erdemts/IO_55_/Dosyalar/cihaz resim.jpg

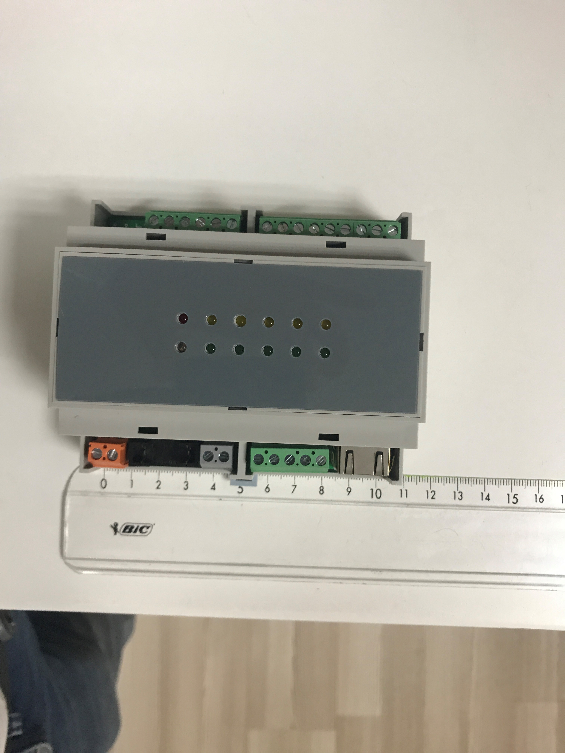
Dosyalar/cihaz resim.jpg
