erdemts/IO_55_/Dosyalar/Bullwark.jpg

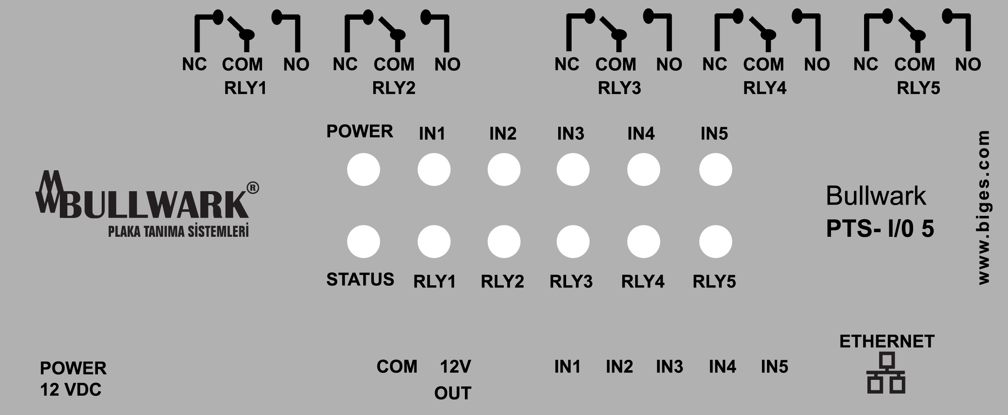
Dosyalar/Bullwark.jpg
