erdemts/IO_55_/Dosyalar/INNO_leksan_IO.PNG

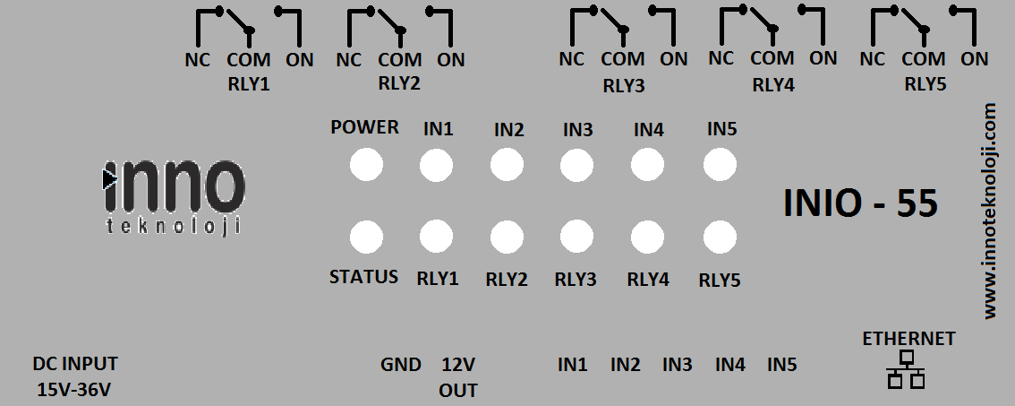
Dosyalar/INNO_leksan_IO.PNG
