erdemts/IO_55_/Dosyalar/Kutu.JPG

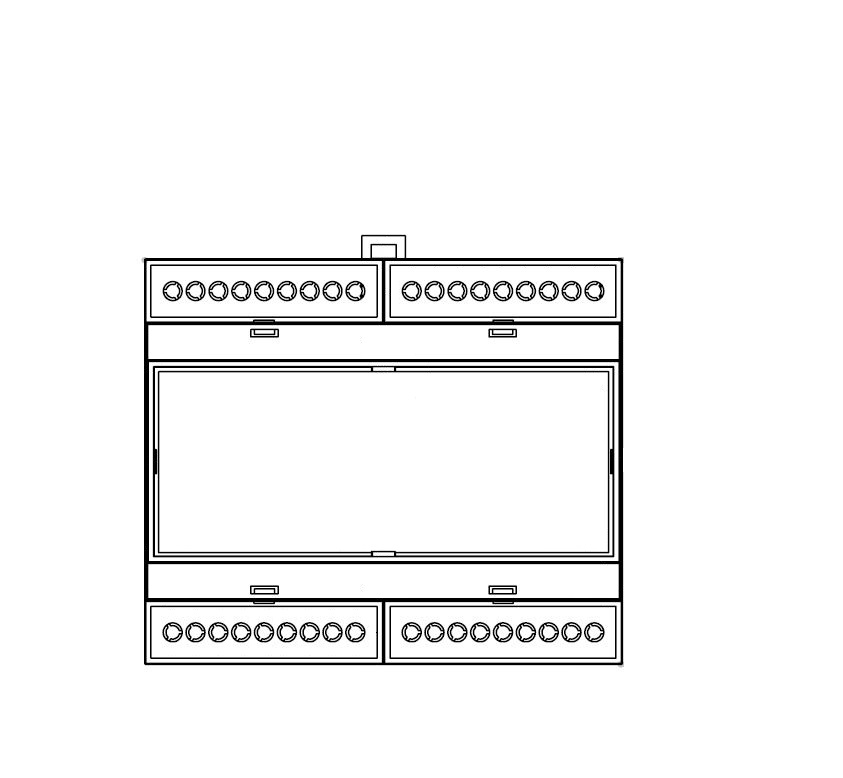
Dosyalar/Kutu.JPG
