erdemts/IO_55_/Dosyalar/leksan_IO_.PNG

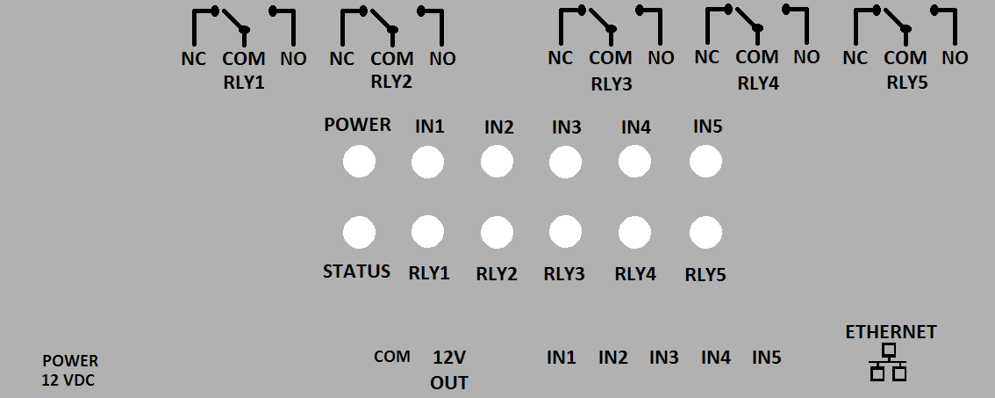
Dosyalar/leksan_IO_.PNG
