erdemts/IO_55_/Dosyalar/IO_Module.xlsx

Sheet: IO_Module (2)
Qty | Value | Device | Package | Parts
2 |  | FE10-2 | FE10-2 | SV1, SV2 | 0.3 | 0.6
1 |  | PINHD-1X5 | 1X05 | ICSP | 0.02 | 0.02
7 | 0R | R-EU_M0805 | M0805 | R7, R15, R16, R17, R18, R19, R20 | 0.0008 | 0.0056
5 | 100nF | C-EUC0603 | C0603 | C4, C6, C8, C10, C41 | 0.0022 | 0.011
3 | 100nF | C-EUC0603K | C0603K | C1, C2, C3 | 0.0022 | 0.0066
1 | 100uF | CPOL-EU153CLV-0605 | 153CLV-0605 | C55 | 0.11 | 0.11
1 | 100uF 50V | CPOL-EU153CLV-0810 | 153CLV-0810 | C9, C30 | 0.1 | 0.1
5 | 10K | R-EU_M0805 | M0805 | R4, R53, R55, R57, R59 | 0.0008 | 0.004
3 | 10K | R-EU_R0805 | R0805 | R3, R6, R11 | 0.0008 | 0.0024
1 | 10uF | CPOL-EU153CLV-0505 | 153CLV-0505 | C5 | 0.05 | 0.05
5 | 1K | R-EU_M0805 | M0805 | R5, R54, R56, R58, R60 | 0.0008 | 0.004
6 | 1N4148 | GF1 | SMA-DO214AC | D1, D2, D3, D4, D5, D6 | 0.006 | 0.036
1 | 2k | R-EU_M0805 | M0805 | R111 | 0.0008 | 0.0008
2 | 3k3 | R-EU_R0805 | R0805 | R79, R80 | 0.0008 | 0.0016
1 | 4.7uF 25V | CPOL-USA/3216-18R | A/3216-18R | C7 | 0.05 | 0.05
1 | 470R | R-EU_R0805 | R0805 | R2 | 0.0008 | 0.0008
2 | 47k | R-EU_R0805 | R0805 | R81, R82 | 0.0008 | 0.0016
7 | 620R | R-EU_R0805 | R0805 | R1, R8, R9, R10, R12, R13, R14 | 0.0008 | 0.0056
2 | BC817-16LT1SMD | BC817-16LT1SMD | SOT23-BEC | Q8, Q9 | 0.0095 | 0.019
1 | DIODEBRIDGE | DIODEBRIDGE | SDIP | DB1 | 0.1 | 0.1
5 | JW1FSN-DC12V | G5Q-1-12V | G5Q-1-12V | RLY1, RLY2, RLY3, RLY4, RLY5 | 0.41 | 2.05
1 | L7805CD2T-TR | VREG-7805-DPAK2 | VREG-7805-DPAK2 | U$6 | 0.25 | 0.25
2 | LD117AS12TR | LD117AS12TR | SOT223 | IC3, IC4 | 0.12 | 0.24
2 | MKDSN1,5/2-5,08 | MKDSN1,5/2-5,08 | MKDSN1,5/2-5,08 | X2, X9 | 0.1 | 0.2
5 | MKDSN1,5/3-5,08 | MKDSN1,5/3-5,08 | MKDSN1,5/3-5,08 | X4, X5, X6, X7, X8 | 0.135 | 0.675 | 10.53
1 | MKDSN1,5/5-5,08 | MKDSN1,5/5-5,08 | MKDSN1,5/5-5,08 | X1 | 0.22 | 0.22
1 | PIC16F887PT | PIC16F877PT | TQFP44 | IC1 | 1.5 | 1.5
1 | PILOT_FUSEHOLD |  |  | FUSE | 0.15 | 0.15
12 | TLLR4400 | TLLR4400 | LED3MM | LED1, LED3, LED4, LED5, LED6, LED7, LED8, LED9, LED10, LED11, LED12, LED13 | 0.02 | 0.24
5 | TLP283 | TLP283 | MINI-FLAT-4 | OK1, OK2, OK3, OK4, OK8 | 0.25 | 1.25
1 | ULN2003AD | ULN2003AD | SO16 | IC7 | 0.14 | 0.14
1 | USR-K2 | USR-K2 | USR-K2 | ETH2 | 11.33 | 11.33
1 | fuse |  |  |  | 0.1 | 0.1
1 | pcb |  |  |  | 2.5 | 2.5
1 | kutu |  |  |  | 6.4 | 6.4
1 | dizgi |  |  |  | 3.5 | 3.5
1 | membran |  |  |  | 0.8 | 0.8
 |  |  |  |  |  | 32.674 | 42.4762 | 29.254 | 13.2222 | 396.666
 |  |  |  |  |  |  |  |  |  | 407.196
 |  |  |  |  |  |  |  |  |  | 84.9524
 |  |  |  |  |  |  |  |  |  | 492.1484
 |  |  |  |  |  |  |  |  |  | 500

Sheet: IO_Module
Qty | Value | Device | Package | Parts
1 |  | CRYSTALHC49UP | HC49UP | Q3 | 0 | 0
2 |  | FE10-2 | FE10-2 | SV1, SV2 | 0.3 | 0.6
0 |  | LEDCHIPLED_0805 | CHIPLED_0805 | LED2 | 0 | 0
1 |  | PINHD-1X5 | 1X05 | ICSP | 0.02 | 0.02
7 | 0R | R-EU_M0805 | M0805 | R7, R15, R16, R17, R18, R19, R20 | 0.0008 | 0.0056
5 | 100nF | C-EUC0603 | C0603 | C4, C6, C8, C10, C41 | 0.0022 | 0.011
3 | 100nF | C-EUC0603K | C0603K | C1, C2, C3 | 0.0022 | 0.0066
1 | 100uF | CPOL-EU153CLV-0605 | 153CLV-0605 | C55 | 0.11 | 0.11
1 | 100uF 50V | CPOL-EU153CLV-0810 | 153CLV-0810 | C9, C30 | 0.1 | 0.1
5 | 10K | R-EU_M0805 | M0805 | R4, R53, R55, R57, R59 | 0.0008 | 0.004
3 | 10K | R-EU_R0805 | R0805 | R3, R6, R11 | 0.0008 | 0.0024
1 | 10uF | CPOL-EU153CLV-0505 | 153CLV-0505 | C5 | 0.05 | 0.05
0 | 14k | R-EU_M0805 | M0805 | R68 | 0.0008 | 0
5 | 1K | R-EU_M0805 | M0805 | R5, R54, R56, R58, R60 | 0.0008 | 0.004
6 | 1N4148 | GF1 | SMA-DO214AC | D1, D2, D3, D4, D5, D6 | 0.006 | 0.036
0 | 220uH | DR125 | DR125 | L5 | 0.15 | 0
0 | 22pF | C-EUC0805 | C0805 | C31, C32 | 0.0022 | 0
1 | 2k | R-EU_M0805 | M0805 | R111 | 0.0008 | 0.0008
2 | 3k3 | R-EU_R0805 | R0805 | R79, R80 | 0.0008 | 0.0016
1 | 4.7uF 25V | CPOL-USA/3216-18R | A/3216-18R | C7 | 0.05 | 0.05
1 | 470R | R-EU_R0805 | R0805 | R2 | 0.0008 | 0.0008
2 | 47k | R-EU_R0805 | R0805 | R81, R82 | 0.0008 | 0.0016
7 | 620R | R-EU_R0805 | R0805 | R1, R8, R9, R10, R12, R13, R14 | 0.0008 | 0.0056
0 | B540C_DIODE | B540C_DIODE | SMC | U$13 | 0.085 | 0
2 | BC817-16LT1SMD | BC817-16LT1SMD | SOT23-BEC | Q8, Q9 | 0.0095 | 0.019
1 | DIODEBRIDGE | DIODEBRIDGE | SDIP | DB1 | 0.1 | 0.1
5 | JW1FSN-DC12V | G5Q-1-12V | G5Q-1-12V | RLY1, RLY2, RLY3, RLY4, RLY5 | 0.41 | 2.05
1 | L7805CD2T-TR | VREG-7805-DPAK2 | VREG-7805-DPAK2 | U$6 | 0.25 | 0.25
2 | LD117AS12TR | LD117AS12TR | SOT223 | IC3, IC4 | 0.12 | 0.24
0 | LM2596S | LM2596S | TO263-5 | IC2 | 1 | 0
2 | MKDSN1,5/2-5,08 | MKDSN1,5/2-5,08 | MKDSN1,5/2-5,08 | X2, X9 | 0.1 | 0.2
5 | MKDSN1,5/3-5,08 | MKDSN1,5/3-5,08 | MKDSN1,5/3-5,08 | X4, X5, X6, X7, X8 | 0.135 | 0.675 | 10.53
1 | MKDSN1,5/5-5,08 | MKDSN1,5/5-5,08 | MKDSN1,5/5-5,08 | X1 | 0.22 | 0.22
0 | MOV-10D201K | MOV-10D201K | MOV-10D201K | MOV | 0.12 | 0
1 | PIC16F887PT | PIC16F877PT | TQFP44 | IC1 | 1.5 | 1.5
1 | PILOT_FUSEHOLD |  |  | FUSE | 0.15 | 0.15
12 | TLLR4400 | TLLR4400 | LED3MM | LED1, LED3, LED4, LED5, LED6, LED7, LED8, LED9, LED10, LED11, LED12, LED13 | 0.02 | 0.24
5 | TLP283 | TLP283 | MINI-FLAT-4 | OK1, OK2, OK3, OK4, OK8 | 0.25 | 1.25
1 | ULN2003AD | ULN2003AD | SO16 | IC7 | 0.14 | 0.14
1 | USR-K2 | USR-K2 | USR-K2 | ETH2 | 11.33 | 11.33
1 | fuse |  |  |  | 0.1 | 0.1
1 | elek |  |  |  | 1.25 | 1.25
1 | pcb |  |  |  | 2.5 | 2.5
1 | kutu |  |  |  | 6.4 | 6.4
1 | işçilik |  |  |  | 1.5 | 1.5
1 | dizgi |  |  |  | 3.5 | 3.5
1 | membran |  |  |  | 0.8 | 0.8
 |  |  |  |  |  | 35.424
