erdemts/IO_55_/(list of files, cad)

Other CAD files:
Software/ETH_IO5.X/dist/DEBUG/production/ETH_IO5.X.production.obj
Software/ETH_IO5.X/dist/Release/production/ETH_IO5.X.production.obj
