erdemts/IO_55_/Hardware/IO_Module_Project/IO_Module/IO_Module.brd

## EAGLE design Hardware/IO_Module_Project/IO_Module/IO_Module.brd (2018-05-25)

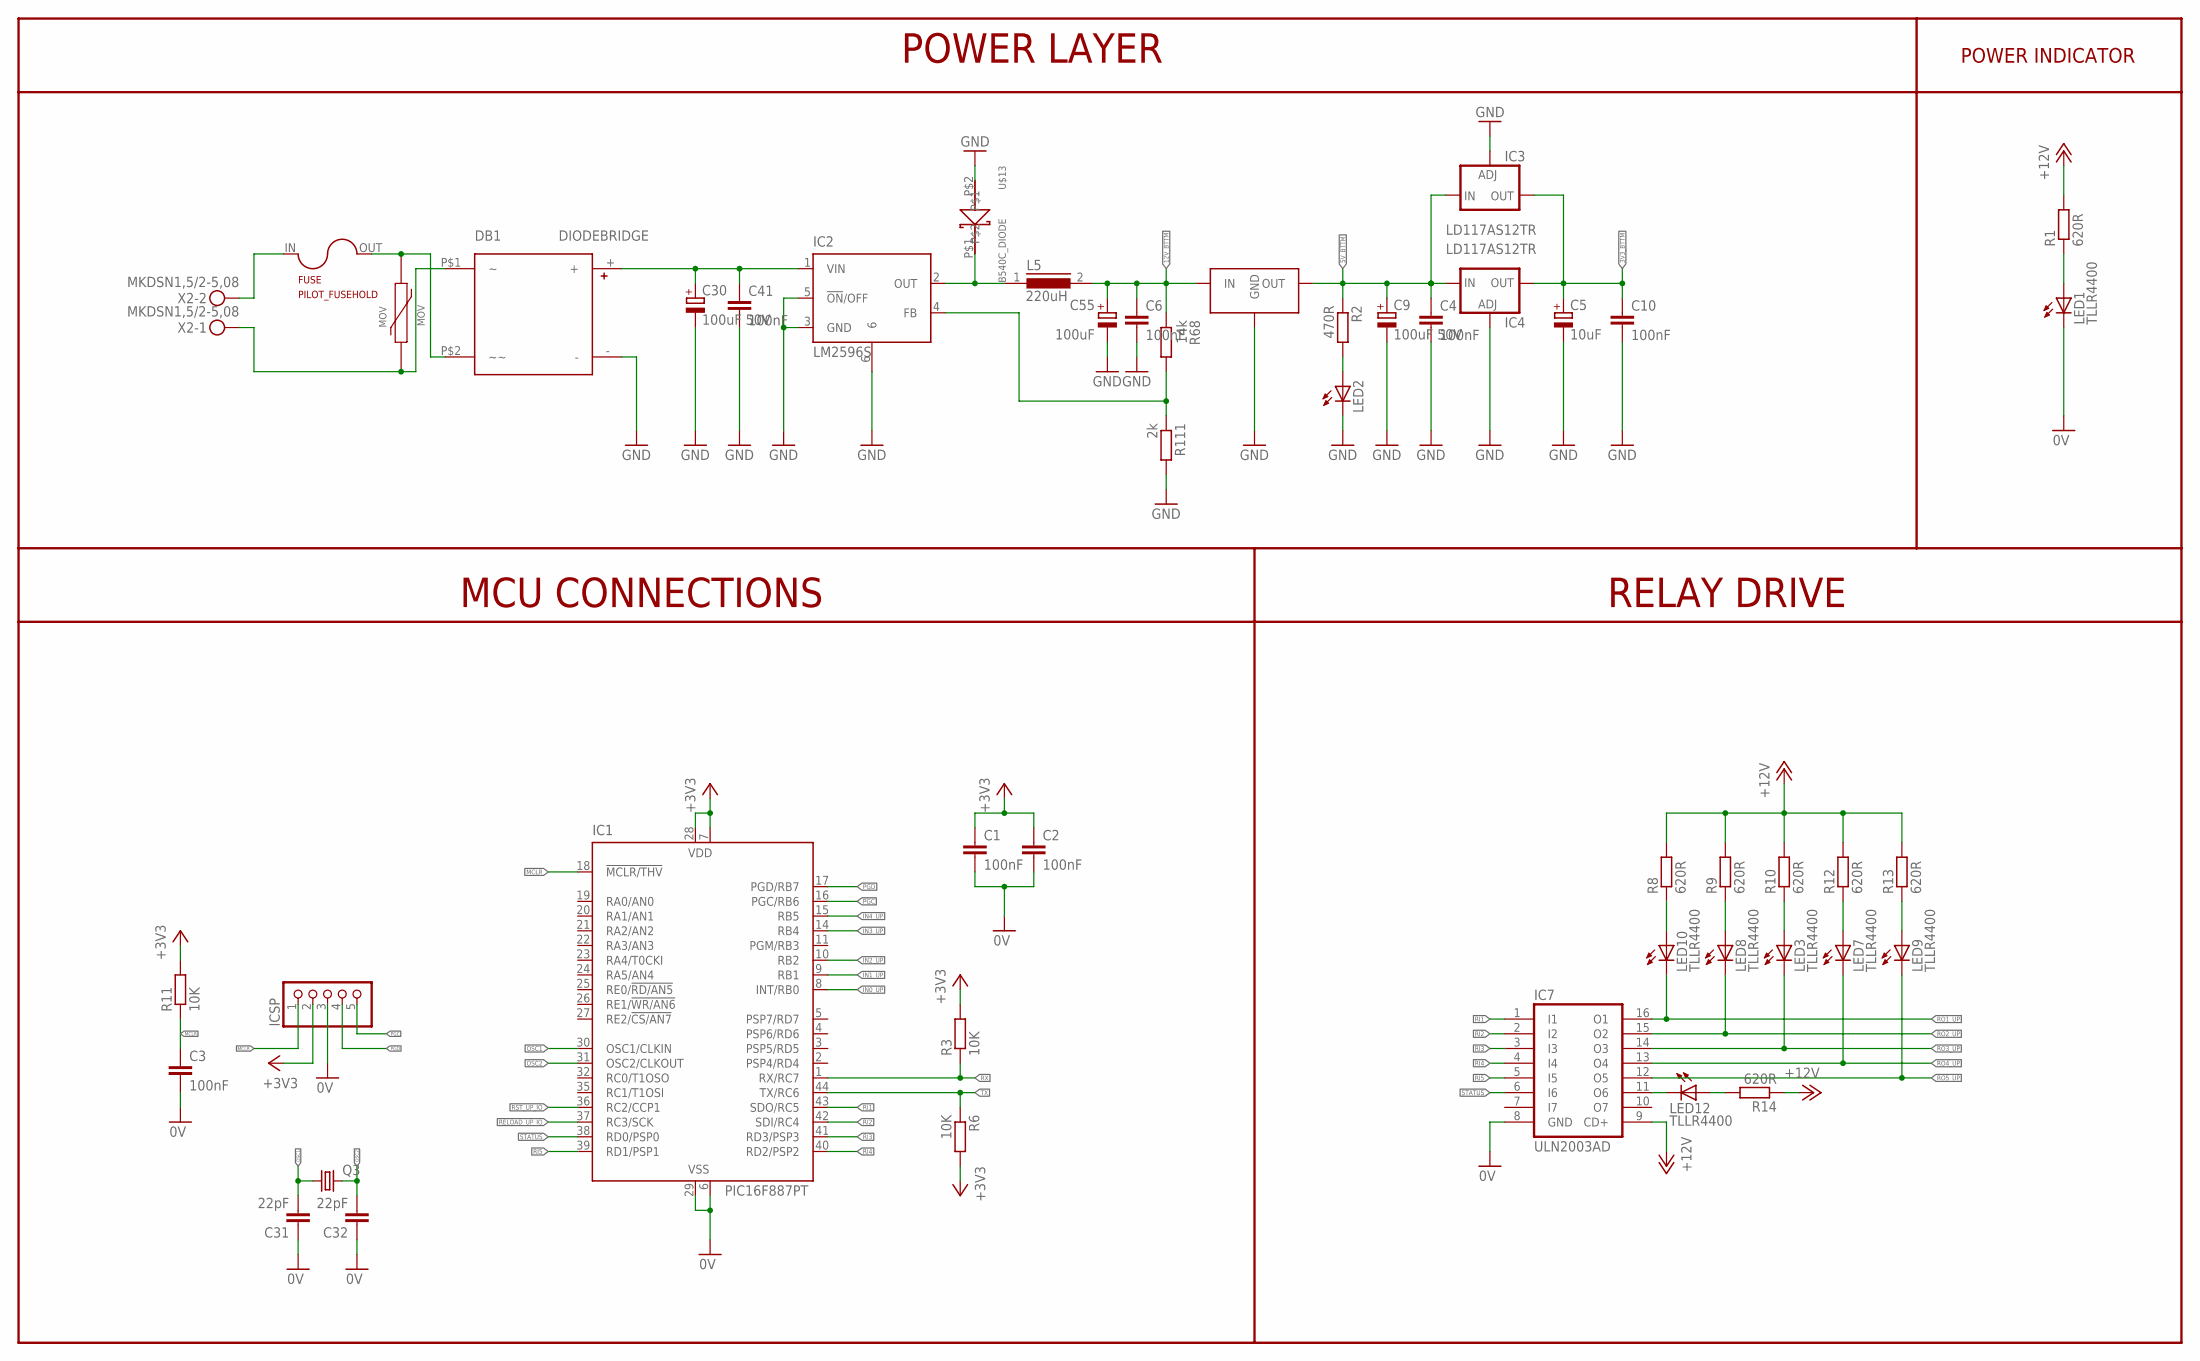
[picture p7: schematic IO_Module.sch, sheet 1]

Parts:
C1, C2, C3: 100nF; C0603K
C4, C6, C10, C41: 100nF; C0603
C5: 10uF; 153CLV-0505
C9, C30: 100uF 50V; 153CLV-0810
C31, C32: 22pF; C0805
C55: 100uF; 153CLV-0605
DB1: DIODEBRIDGE; SDIP
FUSE: PILOT_FUSEHOLD; RTM_FUSEHOLD
IC1: PIC16F887PT; TQFP44
IC2: LM2596S; TO263-5
IC3, IC4: LD117AS12TR; SOT223
IC7: ULN2003AD; SO16
ICSP: PINHD-1X5; 1X05
L5: 220uH; DR125
LED1, LED3, LED7, LED8, LED9, LED10, LED12: TLLR4400; LED3MM
LED2: LEDCHIPLED_0805; CHIPLED_0805
MOV: MOV-10D201K
Q3: CRYSTALHC49UP; HC49UP
R1, R8, R9, R10, R12, R13, R14: 620R; R0805
R2: 470R; R0805
R3, R6, R11: 10K; R0805
R68: 14k; M0805
R111: 2k; M0805
U$6: L7805CD2T-TR; VREG-7805-DPAK2
U$13: B540C_DIODE; SMC
X2: MKDSN1,5/2-5,08

Connections:
0V: C1.2, C2.2, C3.2, C31.1, C32.1, IC1.6 (VSS), IC1.29 (VSS), IC7.8 (GND), ICSP.3, LED1.K (C); also elsewhere on the board
3V3_BTTM: C5.+, C10.1, IC3.4 (OUT), IC4.4 (OUT); also elsewhere on the board
5V_BTTM: C4.1, C9.+, IC3.3 (IN), IC4.3 (IN), R2.1, U$6.VOUT (OUT)
12V_BTTM: C6.1, C55.+, L5.2, R68.1, U$6.VIN (IN); also elsewhere on the board
36V: C30.+, C41.1, DB1.+, IC2.1 (VIN)
+3V3: C1.1, C2.1, IC1.7 (VDD), IC1.28 (VDD), ICSP.2, R3.2, R6.2, R11.2; also elsewhere on the board
+12V: IC7.9 (CD+), R1.2, R8.2, R9.2, R10.2, R12.2, R13.2, R14.1; also elsewhere on the board
GND: C4.2, C5.-, C6.2, C9.-, C10.2, C30.-, C41.2, C55.-, DB1.-, IC2.3 (GND), IC2.5 (!ON!/OFF), IC2.6, IC3.1 (ADJ), IC4.1 (ADJ), LED2.C, R111.2, U$6.GND, U$13.P$2; also elsewhere on the board
IN0_UP: IC1.8 (INT/RB0); also elsewhere on the board
IN1_UP: IC1.9 (RB1); also elsewhere on the board
IN2_UP: IC1.10 (RB2); also elsewhere on the board
IN3_UP: IC1.14 (RB4); also elsewhere on the board
IN4_UP: IC1.15 (RB5); also elsewhere on the board
MCLR: C3.1, IC1.18 (!MCLR/THV), ICSP.1, R11.1
unnamed: LED2.A, R2.2
unnamed: DB1.P$2 (~~), FUSE.OUT, MOV.2
unnamed: DB1.P$1, MOV.1, X2.1
unnamed: FUSE.IN, X2.2
unnamed: LED1.A, R1.1
unnamed: IC7.11 (O6), LED12.K (C)
unnamed: LED10.A, R8.1
unnamed: LED8.A, R9.1
unnamed: LED3.A, R10.1
unnamed: LED7.A, R12.1
unnamed: LED9.A, R13.1
unnamed: LED12.A, R14.2
unnamed: IC2.2 (OUT), L5.1, U$13.P$1
unnamed: IC2.4 (FB), R68.2, R111.1
OSC1: C31.2, IC1.30 (OSC1/CLKIN), Q3.1
OSC2: C32.2, IC1.31 (OSC2/CLKOUT), Q3.2
PGC: IC1.16 (PGC/RB6), ICSP.5
PGD: IC1.17 (PGD/RB7), ICSP.4
RELOAD_UP_IO: IC1.37 (RC3/SCK); also elsewhere on the board
RI1: IC1.43 (SDO/RC5), IC7.1 (I1)
RI2: IC1.42 (SDI/RC4), IC7.2 (I2)
RI3: IC1.41 (RD3/PSP3), IC7.3 (I3)
RI4: IC1.40 (RD2/PSP2), IC7.4 (I4)
RI5: IC1.39 (RD1/PSP1), IC7.5 (I5)
RO1_UP: IC7.16 (O1), LED10.K (C); also elsewhere on the board
RO2_UP: IC7.15 (O2), LED8.K (C); also elsewhere on the board
RO3_UP: IC7.14 (O3), LED3.K (C); also elsewhere on the board
RO4_UP: IC7.13 (O4), LED7.K (C); also elsewhere on the board
RO5_UP: IC7.12 (O5), LED9.K (C); also elsewhere on the board
RST_UP_IO: IC1.36 (RC2/CCP1); also elsewhere on the board
RX: IC1.1 (RX/RC7), R3.1; also elsewhere on the board
STATUS: IC1.38 (RD0/PSP0), IC7.6 (I6)
TX: IC1.44 (TX/RC6), R6.1; also elsewhere on the board

Notes on the sheet:
POWER LAYER
MCU CONNECTIONS
RELAY DRIVE
POWER INDICATOR

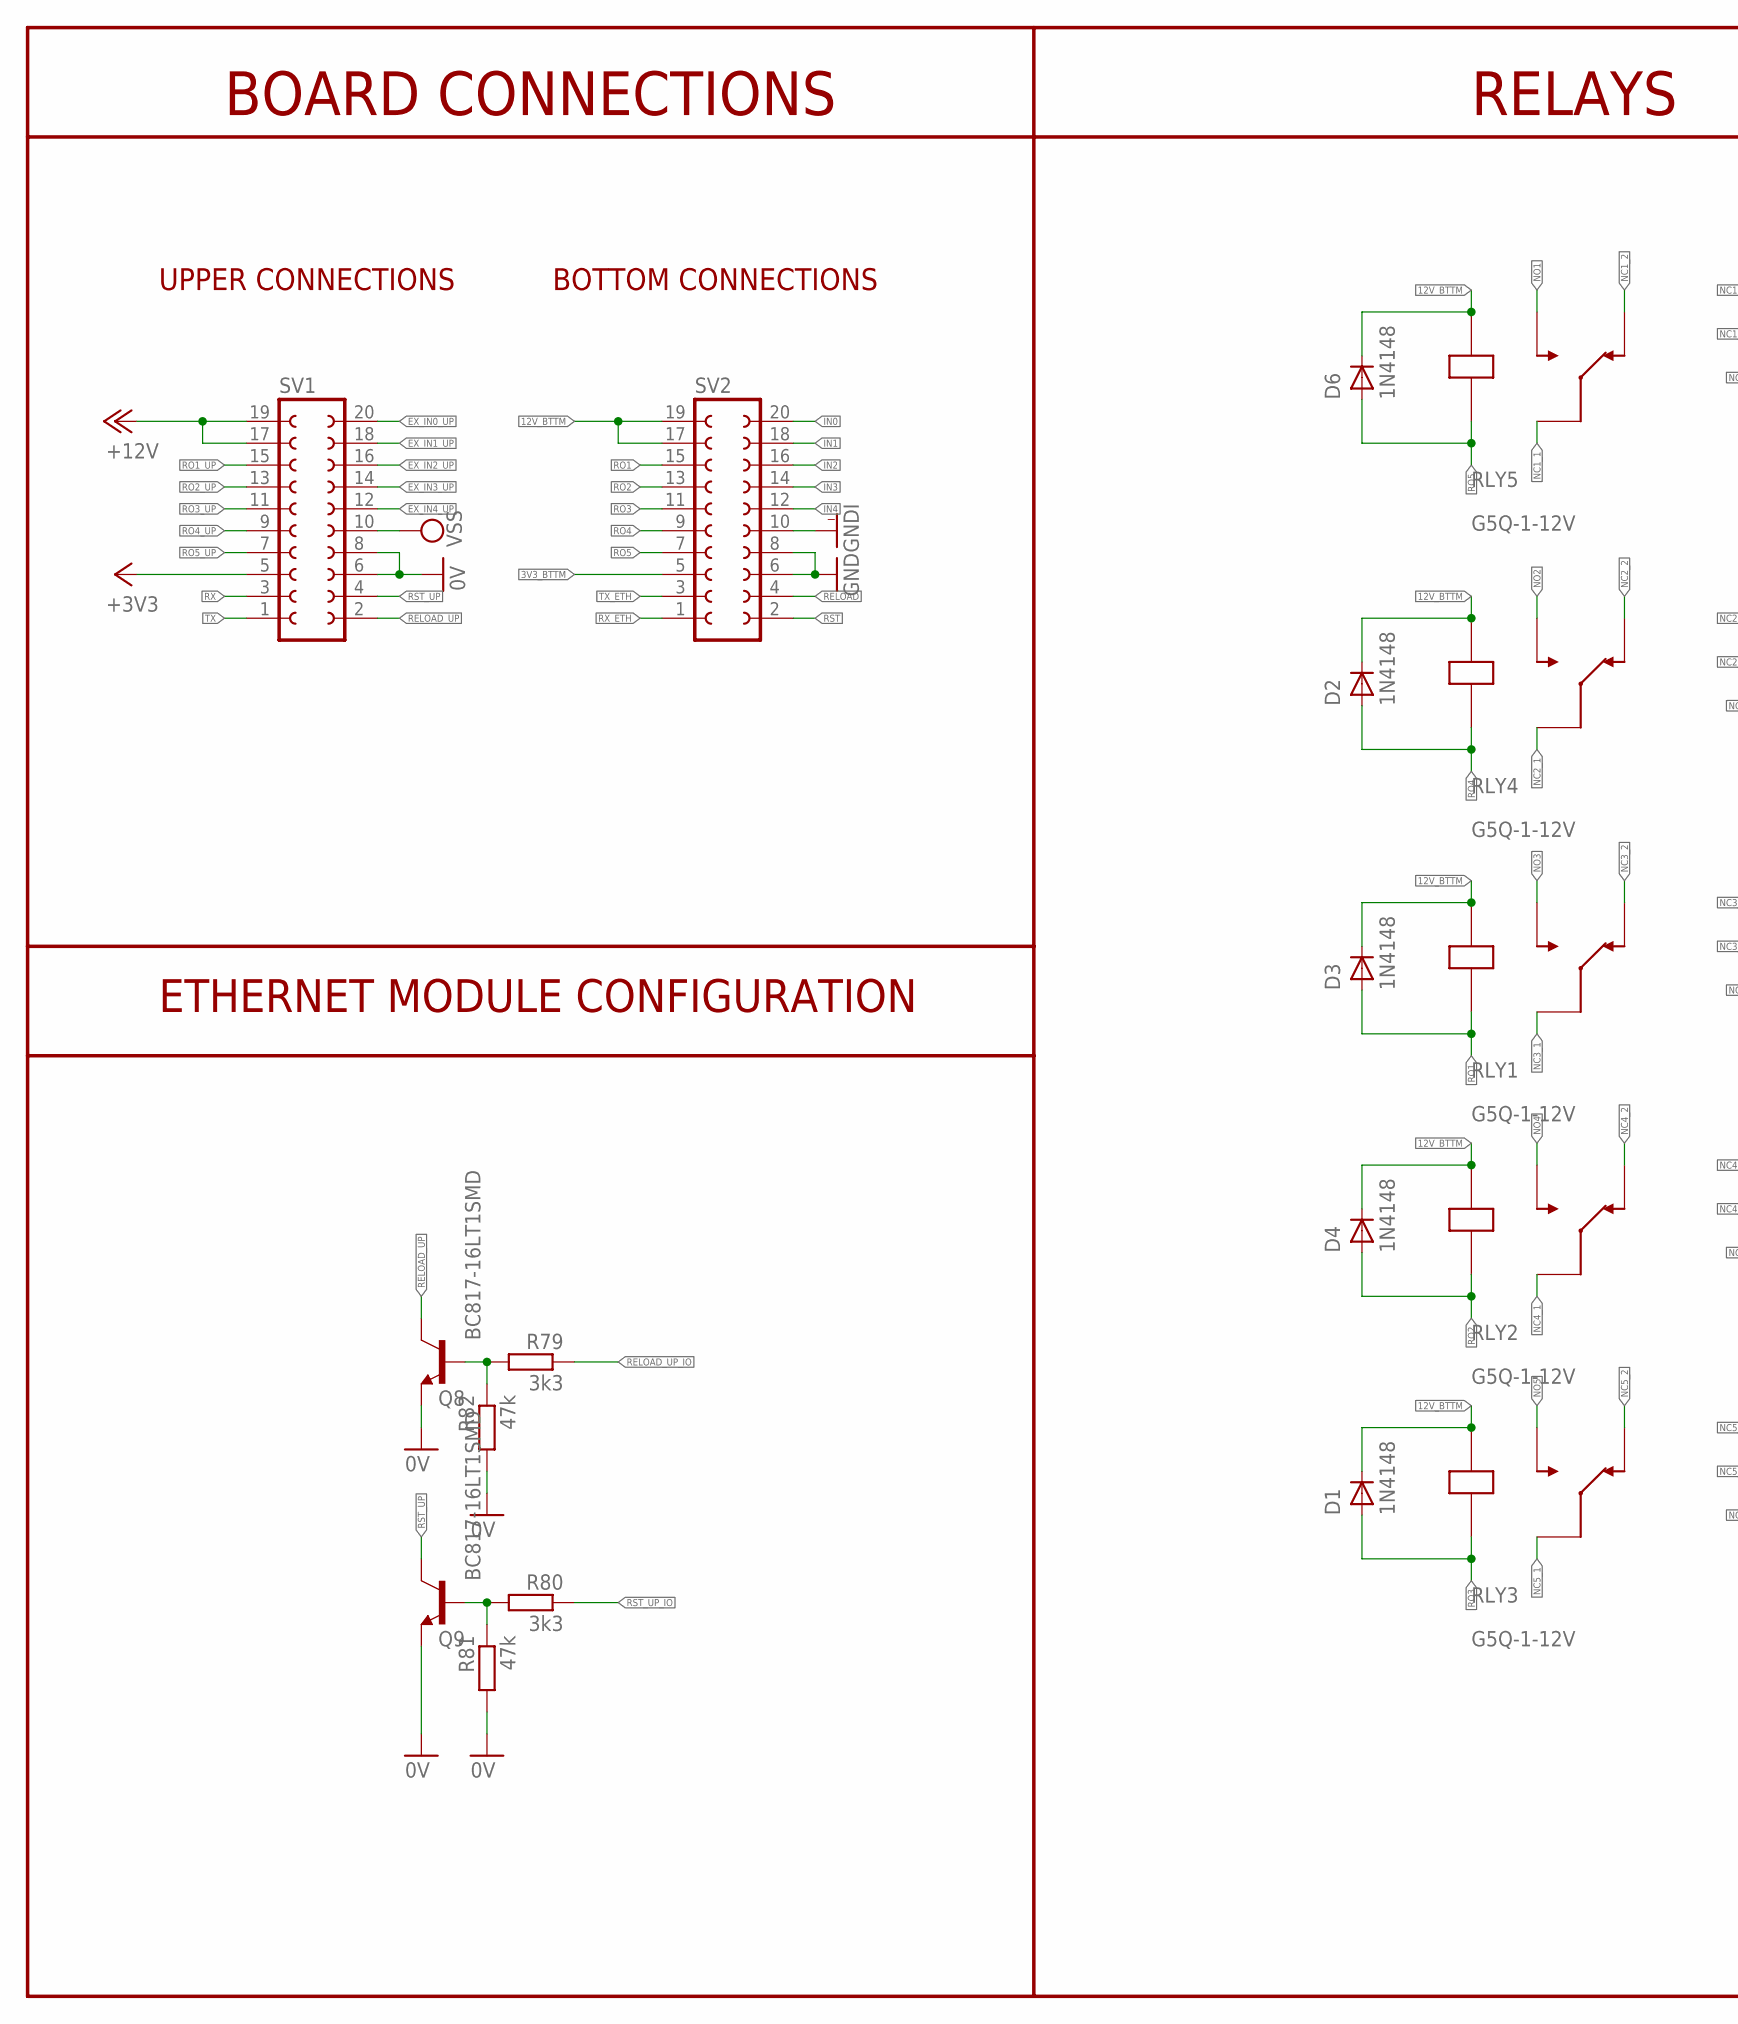
[picture p8: schematic IO_Module.sch, sheet 2, part in row 1, column 1]

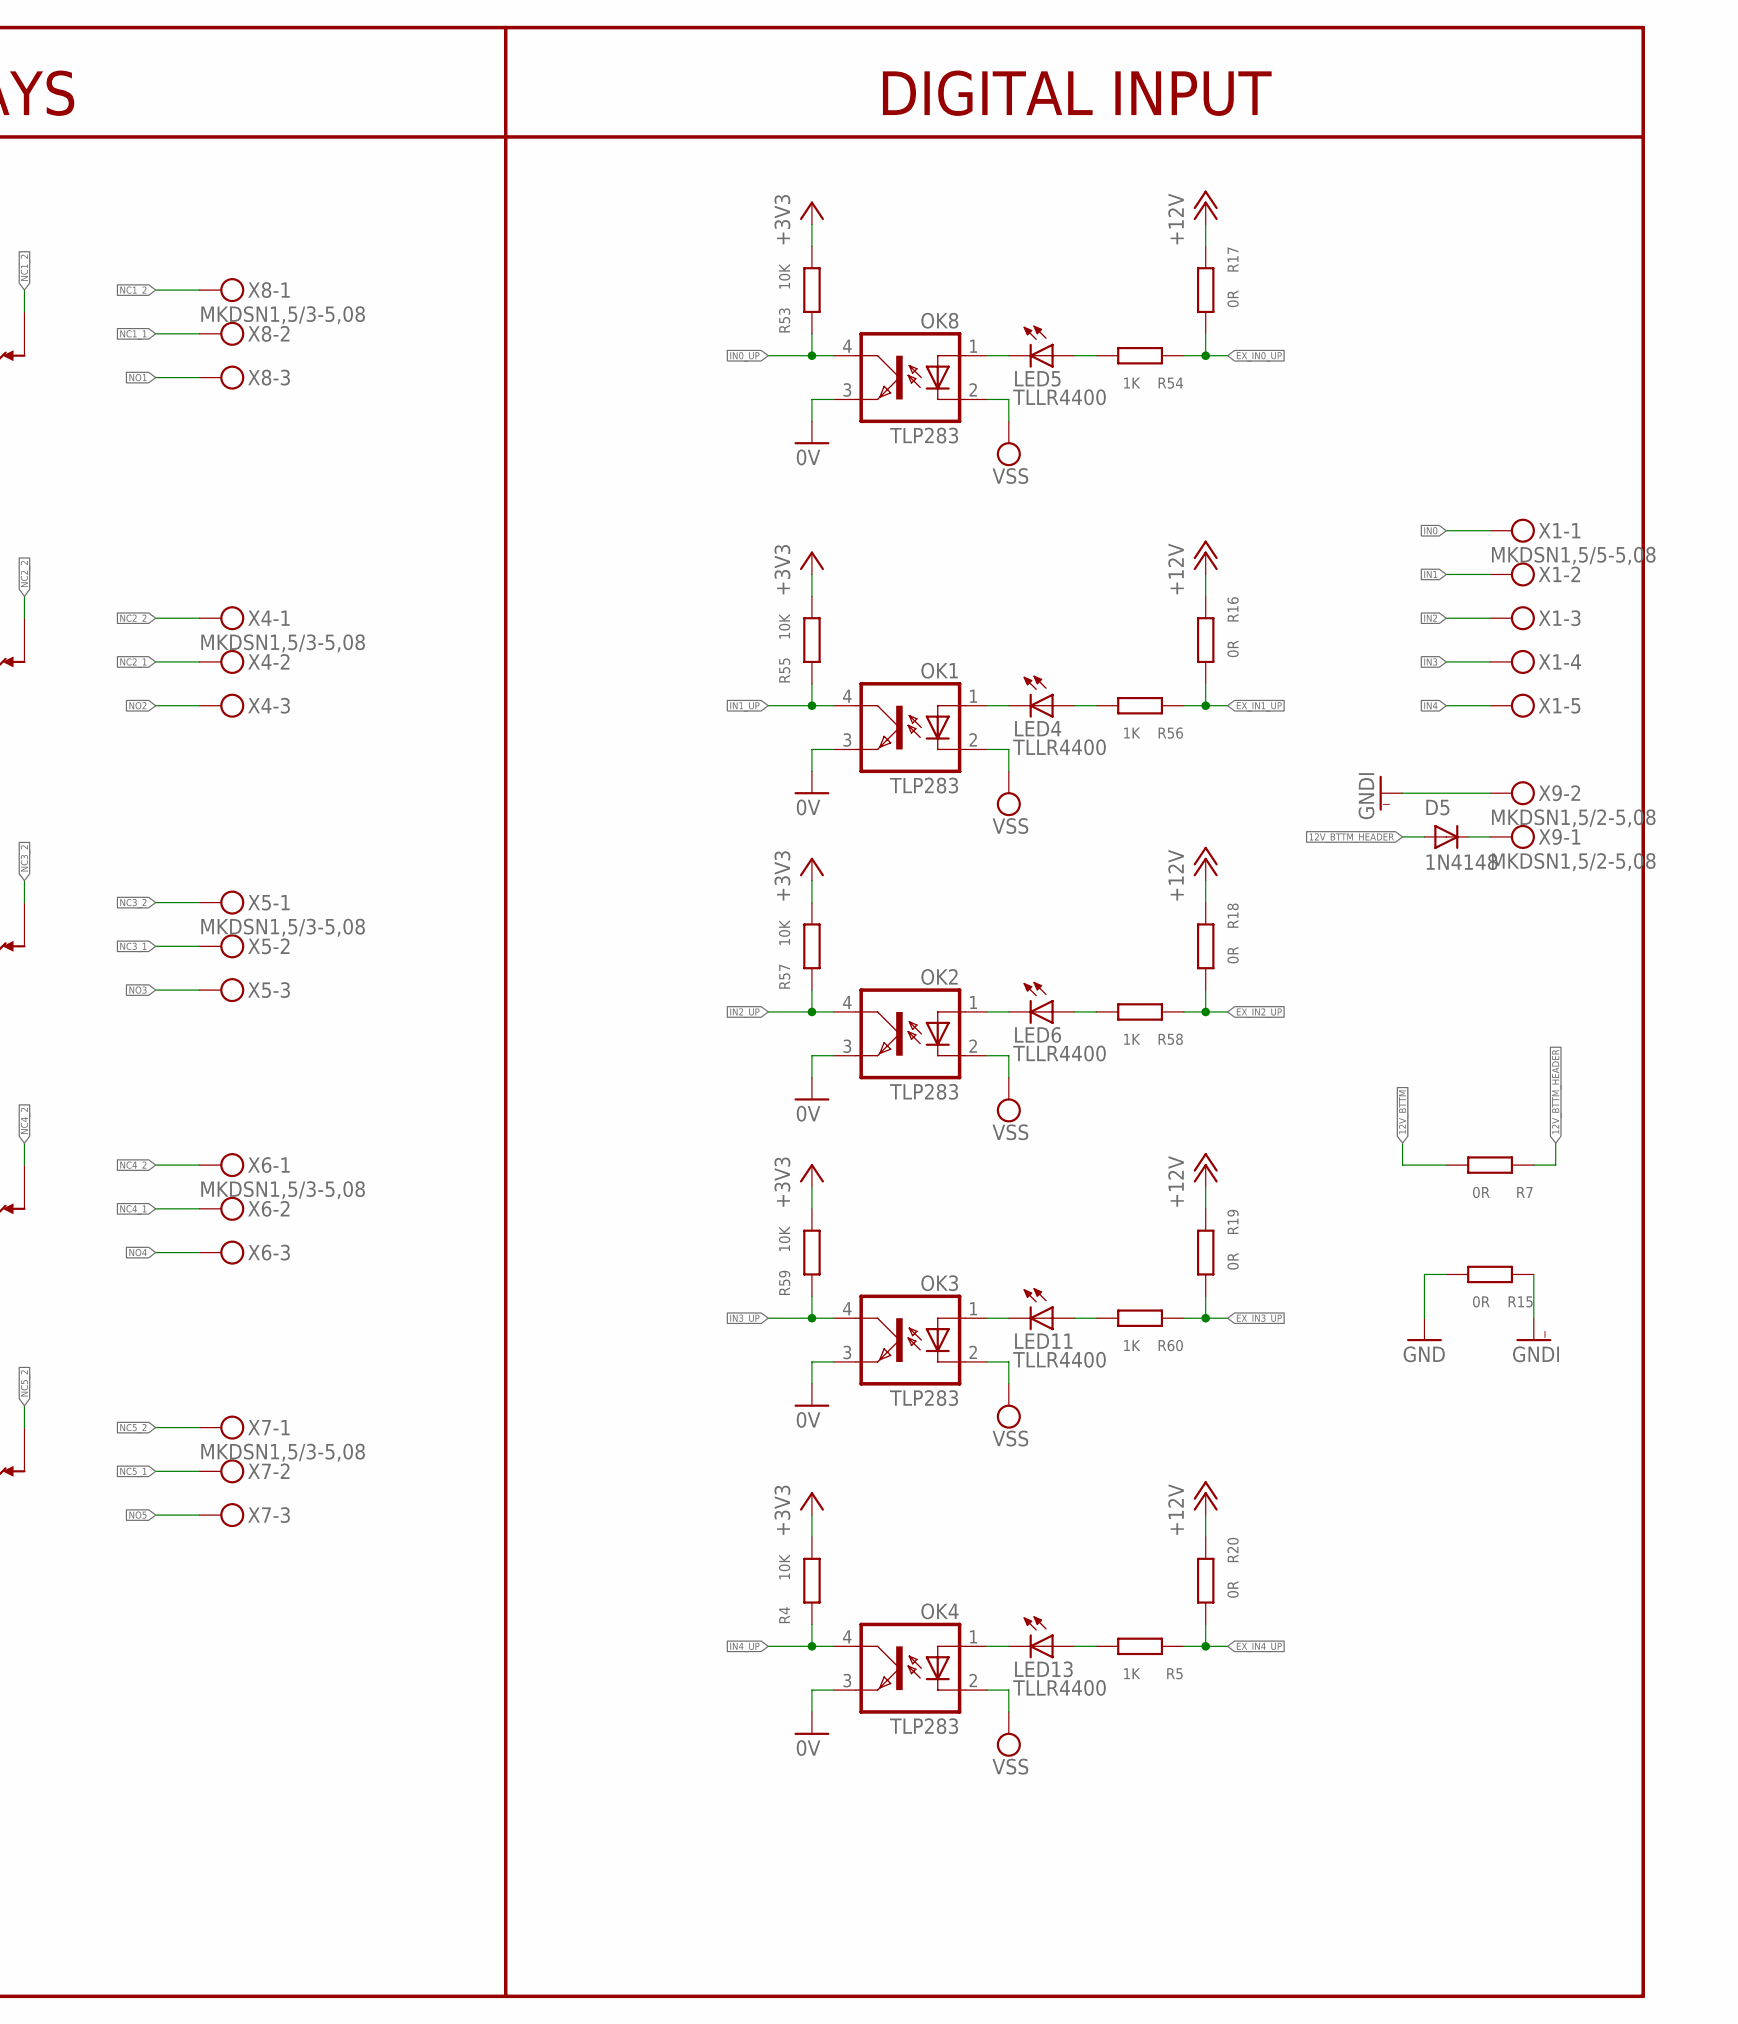
[picture p9: schematic IO_Module.sch, sheet 2, part in row 1, column 2]

Parts:
D1, D2, D3, D4, D5, D6: 1N4148; SMA-DO214AC
LED4, LED5, LED6, LED11, LED13: TLLR4400; LED3MM
OK1, OK2, OK3, OK4, OK8: TLP283; MINI-FLAT-4
Q8, Q9: BC817-16LT1SMD; SOT23-BEC
R4, R53, R55, R57, R59: 10K; M0805
R5, R54, R56, R58, R60: 1K; M0805
R7, R15, R16, R17, R18, R19, R20: 0R; M0805
R79, R80: 3k3; R0805
R81, R82: 47k; R0805
RLY1, RLY2, RLY3, RLY4, RLY5: JW1FSN-DC12V; G5Q-1-12V
SV1, SV2: FE10-2
X1: MKDSN1,5/5-5,08
X4, X5, X6, X7, X8: MKDSN1,5/3-5,08
X9: MKDSN1,5/2-5,08

Connections:
0V: OK1.3 (EMIT), OK2.3 (EMIT), OK3.3 (EMIT), OK4.3 (EMIT), OK8.3 (EMIT), Q8.E, Q9.E, R81.2, R82.2, SV1.6, SV1.8; also elsewhere on the board
3V3_BTTM: SV2.5; also elsewhere on the board
12V_BTTM: D1.K (C), D2.K (C), D3.K (C), D4.K (C), D6.K (C), R7.2, RLY1.1, RLY2.1, RLY3.1, RLY4.1, RLY5.1, SV2.17, SV2.19; also elsewhere on the board
12V_BTTM_HEADER: D5.A, R7.1
+3V3: R4.2, R53.2, R55.2, R57.2, R59.2, SV1.5; also elsewhere on the board
+12V: R16.1, R17.1, R18.1, R19.1, R20.1, SV1.17, SV1.19; also elsewhere on the board
EX_IN0_UP: R17.2, R54.1, SV1.20
EX_IN1_UP: R16.2, R56.1, SV1.18
EX_IN2_UP: R18.2, R58.1, SV1.16
EX_IN3_UP: R19.2, R60.1, SV1.14
EX_IN4_UP: R5.1, R20.2, SV1.12
GND: R15.2, SV2.6, SV2.8; also elsewhere on the board
GNDI: R15.1, SV2.10, X9.2
IN0: SV2.20, X1.1
IN0_UP: OK8.4 (COL), R53.1; also elsewhere on the board
IN1: SV2.18, X1.2
IN1_UP: OK1.4 (COL), R55.1; also elsewhere on the board
IN2: SV2.16, X1.3
IN2_UP: OK2.4 (COL), R57.1; also elsewhere on the board
IN3: SV2.14, X1.4
IN3_UP: OK3.4 (COL), R59.1; also elsewhere on the board
IN4: SV2.12, X1.5
IN4_UP: OK4.4 (COL), R4.1; also elsewhere on the board
unnamed: LED13.K (C), OK4.1 (A)
unnamed: LED13.A, R5.2
unnamed: D5.K (C), X9.1
unnamed: LED5.K (C), OK8.1 (A)
unnamed: LED5.A, R54.2
unnamed: LED4.K (C), OK1.1 (A)
unnamed: LED4.A, R56.2
unnamed: LED6.K (C), OK2.1 (A)
unnamed: LED6.A, R58.2
unnamed: LED11.K (C), OK3.1 (A)
unnamed: LED11.A, R60.2
NC1_1: RLY5.3, X8.2
NC1_2: RLY5.4, X8.1
NC2_1: RLY4.3, X4.2
NC2_2: RLY4.4, X4.1
NC3_1: RLY1.3, X5.2
NC3_2: RLY1.4, X5.1
NC4_1: RLY2.3, X6.2
NC4_2: RLY2.4, X6.1
NC5_1: RLY3.3, X7.2
NC5_2: RLY3.4, X7.1
NO1: RLY5.5, X8.3
NO2: RLY4.5, X4.3
NO3: RLY1.5, X5.3
NO4: RLY2.5, X6.3
NO5: RLY3.5, X7.3
RELOAD: SV2.4; also elsewhere on the board
RELOAD_UP: Q8.C, SV1.2
RELOAD_UP_IO: R79.1; also elsewhere on the board
RO1: D3.A, RLY1.2, SV2.15
RO1_UP: SV1.15; also elsewhere on the board
RO2: D4.A, RLY2.2, SV2.13
RO2_UP: SV1.13; also elsewhere on the board
RO3: D1.A, RLY3.2, SV2.11
RO3_UP: SV1.11; also elsewhere on the board
RO4: D2.A, RLY4.2, SV2.9
RO4_UP: SV1.9; also elsewhere on the board
RO5: D6.A, RLY5.2, SV2.7
RO5_UP: SV1.7; also elsewhere on the board
RST: SV2.2; also elsewhere on the board
RST_UP: Q9.C, SV1.4
RST_UP_IO: R80.1; also elsewhere on the board
RX: SV1.3; also elsewhere on the board
RX_ETH: SV2.1; also elsewhere on the board
TX: SV1.1; also elsewhere on the board
TXD2: Q8.B, R79.2, R82.1
TXD3: Q9.B, R80.2, R81.1
TX_ETH: SV2.3; also elsewhere on the board
VSS: OK1.2 (C), OK2.2 (C), OK3.2 (C), OK4.2 (C), OK8.2 (C), SV1.10

Notes on the sheet:
UPPER CONNECTIONS
BOTTOM CONNECTIONS
ETHERNET MODULE CONFIGURATION
BOARD CONNECTIONS
RELAYS
DIGITAL INPUT

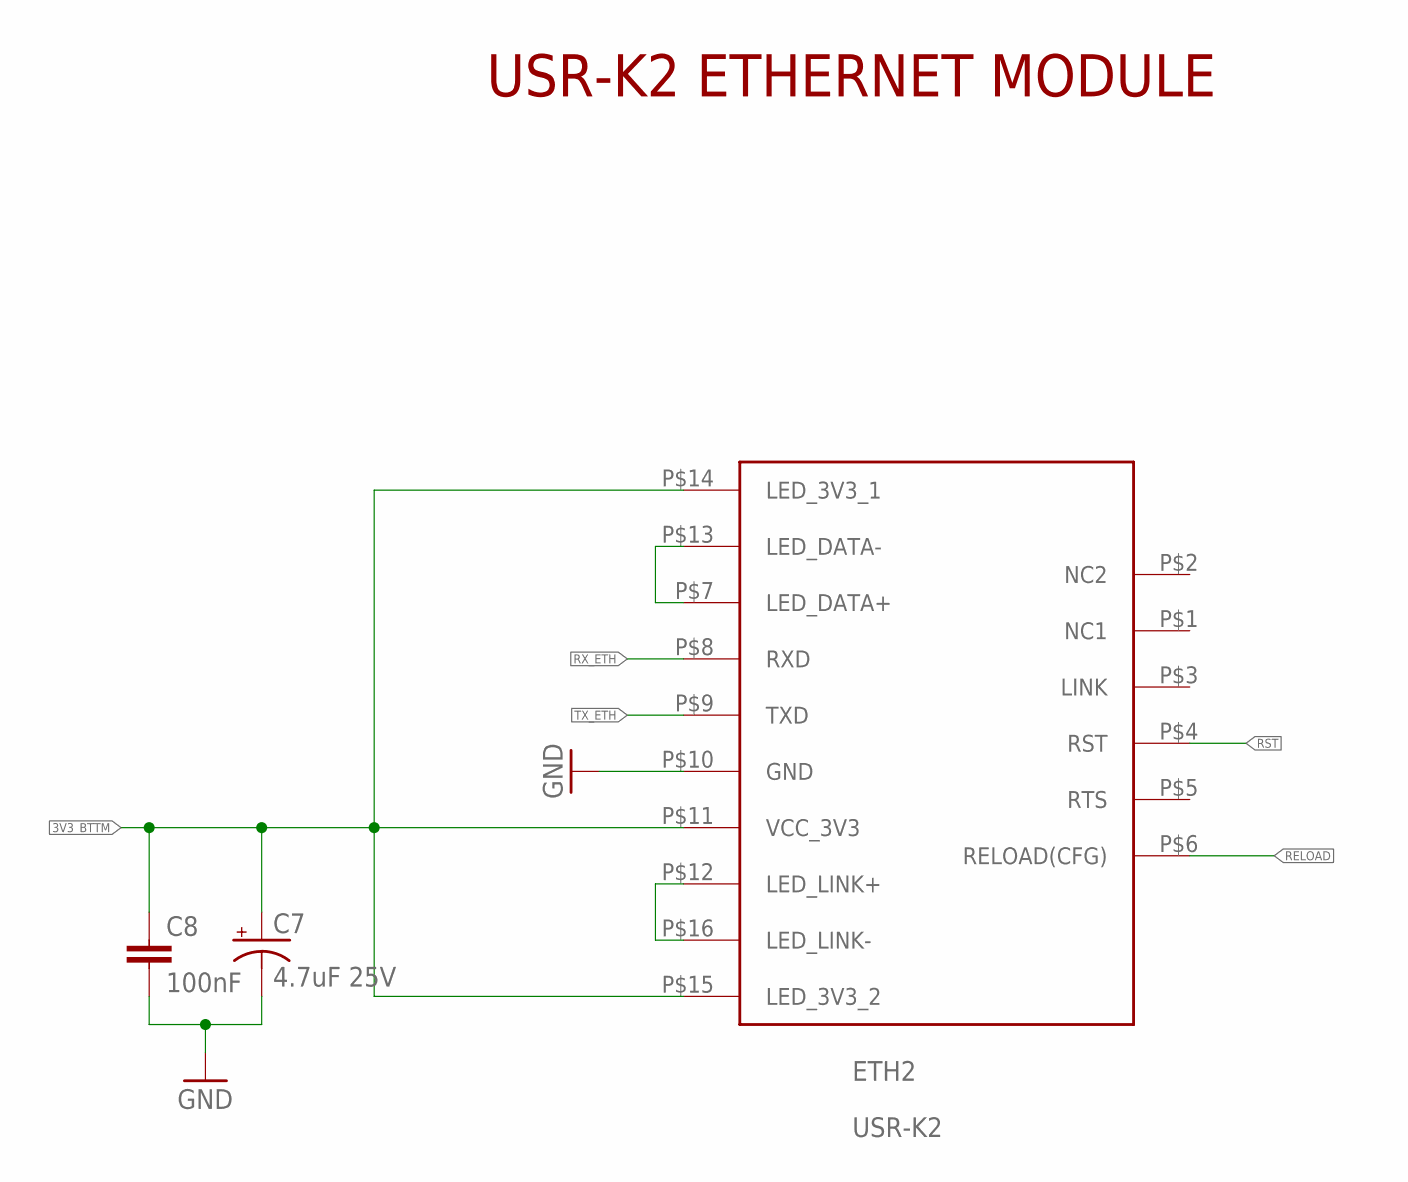
[picture p10: schematic IO_Module.sch, sheet 3]

Parts:
C7: 4.7uF 25V; A/3216-18R
C8: 100nF; C0603
ETH2: USR-K2

Connections:
3V3_BTTM: C7.+, C8.1, ETH2.P$11 (VCC_3V3), ETH2.P$14 (LED_3V3_1), ETH2.P$15 (LED_3V3_2); also elsewhere on the board
GND: C7.-, C8.2, ETH2.P$10 (GND); also elsewhere on the board
unnamed: ETH2.P$12 (LED_LINK+), ETH2.P$16 (LED_LINK-)
unnamed: ETH2.P$7 (LED_DATA+), ETH2.P$13 (LED_DATA-)
RELOAD: ETH2.P$6 (RELOAD(CFG)); also elsewhere on the board
RST: ETH2.P$4 (RST); also elsewhere on the board
RX_ETH: ETH2.P$8 (RXD); also elsewhere on the board
TX_ETH: ETH2.P$9 (TXD); also elsewhere on the board

Notes on the sheet:
USR-K2 ETHERNET MODULE

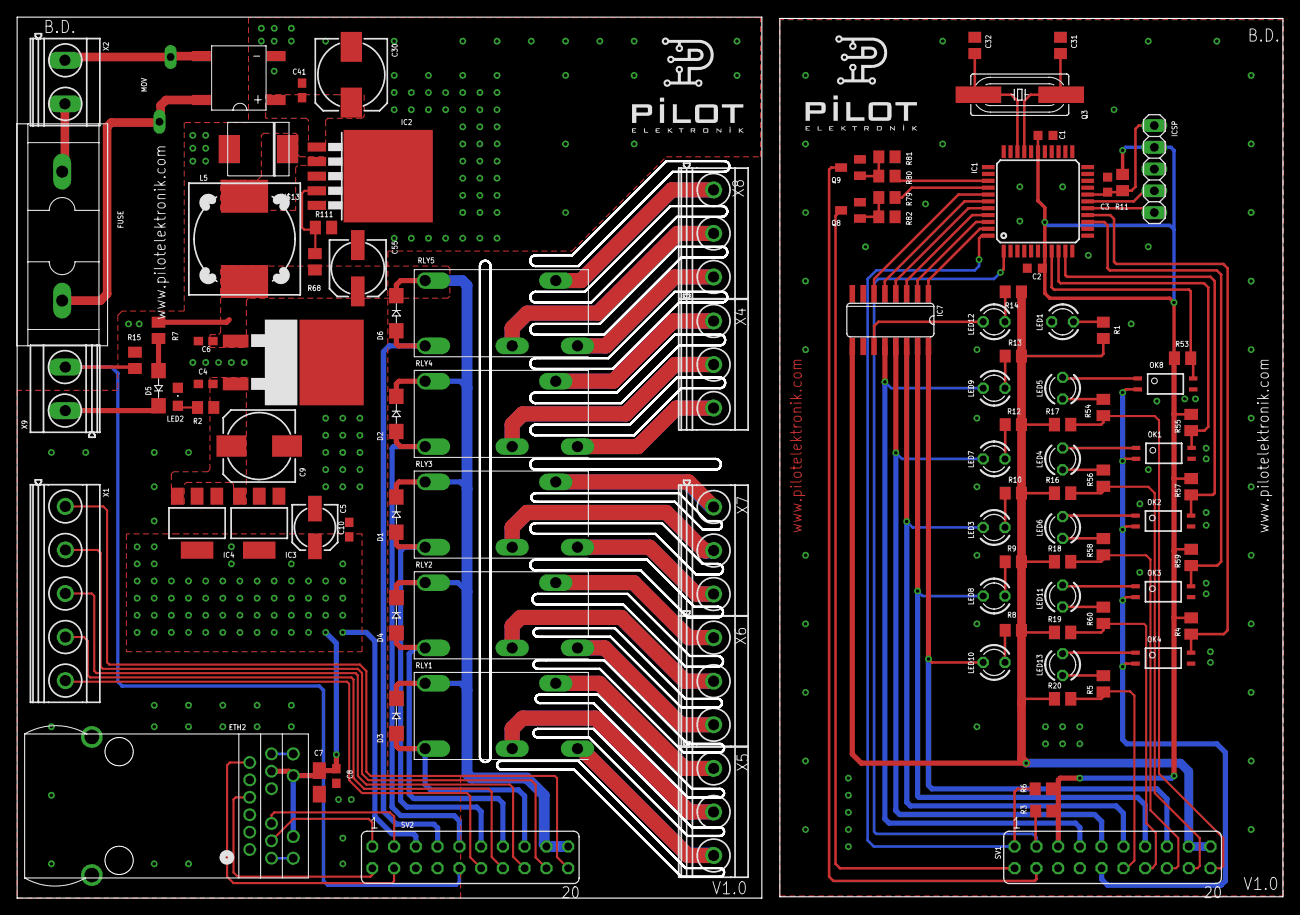
[picture p11: board IO_Module.brd from above]

Board: 2 copper layers, 147.7 x 102.8 mm, 104 parts (0 on the bottom side), 101 nets.
